flurl/shice/kicad/SHICE/SHICE.kicad_pcb

## KiCad design displays_hw/main.kicad_sch

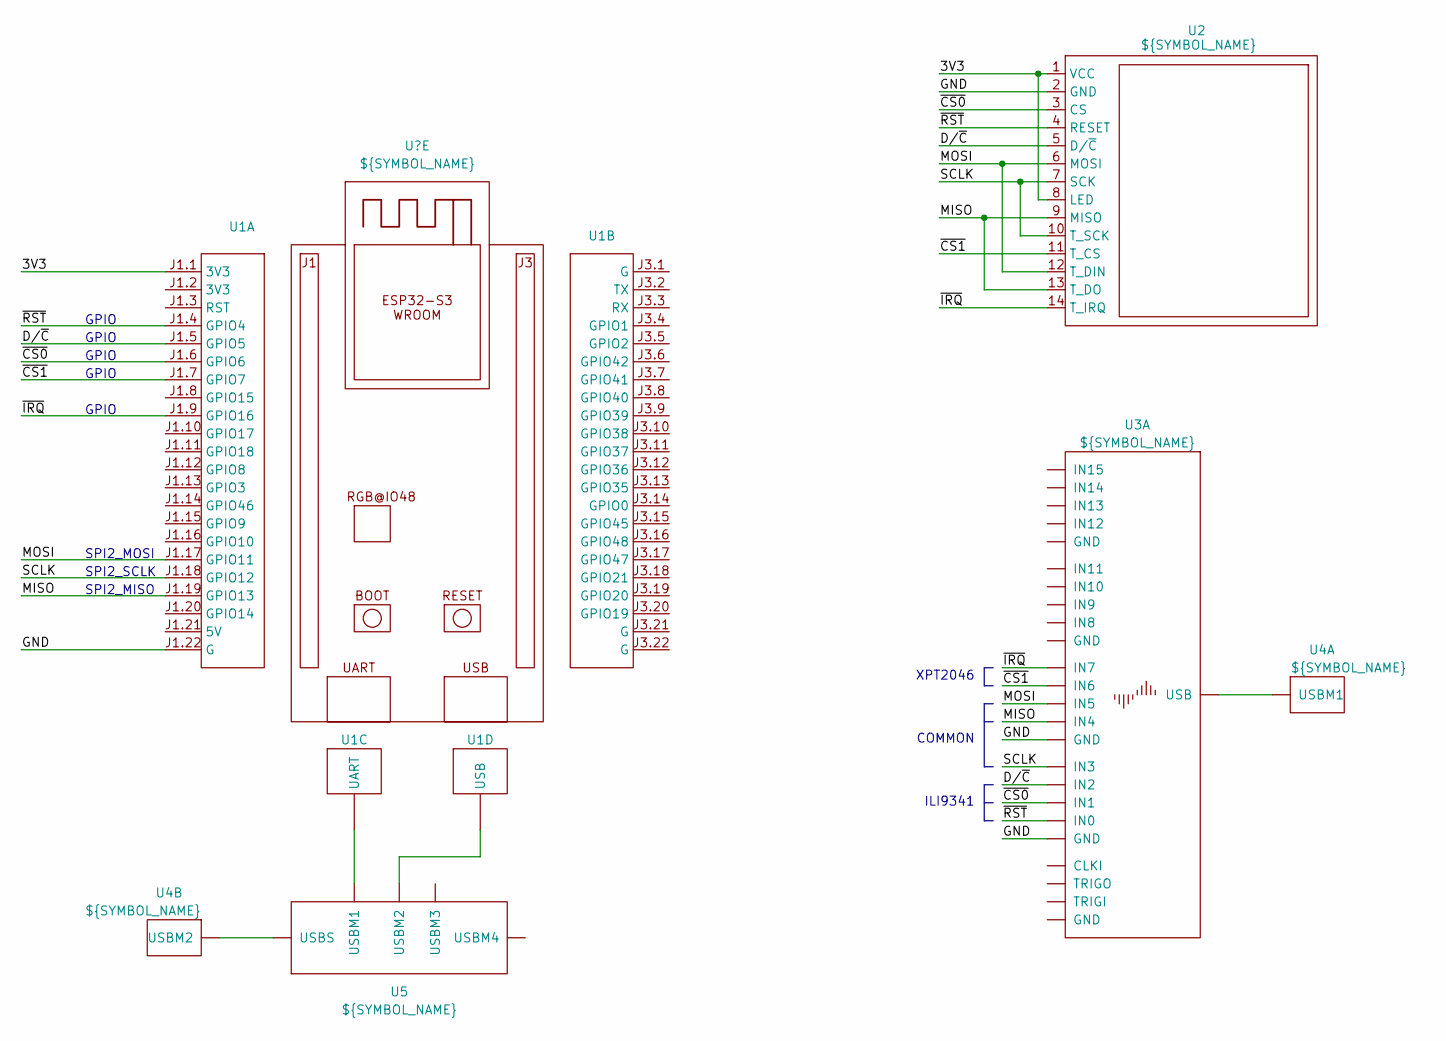
[picture p4: schematic main.kicad_sch]

Parts:
U1, U2, U3, U4, U5: ${SYMBOL_NAME}

Connections:
3V3: U1.J1.1 (3V3), U2.1 (VCC), U2.8 (LED)
D/~C: U1.J1.5 (GPIO5), U2.5 (D/~C), U3.
GND: U1.J1.22 (G), U2.2 (GND), U3.
MISO: U1.J1.19 (GPIO13), U2.9 (MISO), U2.13 (T_DO), U3.
MOSI: U1.J1.17 (GPIO11), U2.6 (MOSI), U2.12 (T_DIN), U3.
unnamed: U1. (UART), U5.
unnamed: U3., U4.
unnamed: U4., U5.
SCLK: U1.J1.18 (GPIO12), U2.7 (SCK), U2.10 (T_SCK), U3.
~CS0: U1.J1.6 (GPIO6), U2.3 (CS), U3.
~CS1: U1.J1.7 (GPIO7), U2.11 (T_CS), U3.
~IRQ: U1.J1.9 (GPIO16), U2.14 (T_IRQ), U3.
~RST: U1.J1.4 (GPIO4), U2.4 (RESET), U3.

Notes on the sheet:
SPI2_SCLK
XPT2046
COMMON
GPIO
SPI2_MISO
ILI9341
SPI2_MOSI
