flurl/shice/(commit log)

2024-07-15 Remove debug print
2024-07-16 Add Arduino code to repository
2024-07-18 Add KiCad files
    [SHICE.kicad_pcb, SHICE.kicad_sch]
